CBorowski-dev/ShutterControlESP8266/electronics/ESP-12F SMD Board/ESP-12F Board.ods

Reference | Value | Footprint | Pollin | Reichelt | Preis | Stück
C1 | 22µF Tantal | Capacitor_Tantalum_SMD:CP_EIA-3528-21_Kemet-B_Pad1.50x2.35mm_HandSolder |  | https://www.reichelt.de/smd-tantal-22-f-16v-125-c-t491b-22u-16-p206454.html?&trstct=pos_6&nbc=1 | 0,23 | 10 | 2,3
C2 | 22µF Tantal | Capacitor_Tantalum_SMD:CP_EIA-3528-21_Kemet-B_Pad1.50x2.35mm_HandSolder |  | siehe C1 |  |  | 0
C3 | 100nF Kerko | Capacitor_SMD:C_1206_3216Metric_Pad1.42x1.75mm_HandSolder |  | https://www.reichelt.de/vielschicht-kerko-100nf-50v-125-c-kem-x7r1206b100n-p207152.html?trstct=pos_4&nbc=1 | 0,04 | 25 | 1
C4 | 100nF Kerko | Capacitor_SMD:C_1206_3216Metric_Pad1.42x1.75mm_HandSolder |  | siehe C3 |  |  | 0
C5 | 100µF Tantal | Capacitor_Tantalum_SMD:CP_EIA-3528-21_Kemet-B_Pad1.50x2.35mm_HandSolder |  | https://www.reichelt.de/smd-tantal-100-f-6v-125-c-t491b-100u-6-p206458.html?&trstct=pos_6&nbc=1 | 0,22 | 5 | 1,1
R1 | 10k | Resistor_SMD:R_1206_3216Metric_Pad1.42x1.75mm_HandSolder |  | https://www.reichelt.de/smd-widerstand-1206-10-kohm-250-mw-1-rnd-1206-1-10k-p183394.html?trstct=pos_3&nbc=1 | 0,02 | 50 | 1
R2 | 10k | Resistor_SMD:R_1206_3216Metric_Pad1.42x1.75mm_HandSolder |  | siehe R1 |  |  | 0
R3 | 10k | Resistor_SMD:R_1206_3216Metric_Pad1.42x1.75mm_HandSolder |  | siehe R1 |  |  | 0
R4 | 10k | Resistor_SMD:R_1206_3216Metric_Pad1.42x1.75mm_HandSolder |  | siehe R1 |  |  | 0
U2 | AMS1117-3.3 | Package_TO_SOT_SMD:SOT-223 |  |  |  |  | 0
 |  |  |  |  |  |  | 0
J3 | Conn_01x10_Male | Connector_PinHeader_2.54mm:PinHeader_1x10_P2.54mm_Vertical | https://www.pollin.de/p/stiftleiste-vergoldet-1x-20-polig-10-stueck-451550 |  | 2,75 | 1 | 2,75
 |  |  |  | https://www.reichelt.de/stiftleiste-20-polig-raster-2-54mm-bkl-10120204-p235649.html?trstct=pol_1&nbc=1 | 0,33 | 6 | 1,98
J4 | Conn_01x08_Male | Connector_PinHeader_2.54mm:PinHeader_1x08_P2.54mm_Vertical | siehe J3 |  |  |  | 0
J1 | Conn_01x04_Male | Connector_PinHeader_2.54mm:PinHeader_1x04_P2.54mm_Vertical | siehe J3 |  |  |  | 0
SW1 | SW_Reset | Button_Switch_THT:SW_PUSH_6mm | https://www.pollin.de/p/printtaster-mikro-eingabetaster-420035 |  | 0,14 | 15 | 2,1
 |  |  |  | https://www.reichelt.de/printtaster-tht-2-45-n-6-x-6-x-5-mm-rnd-210-00193-p226414.html?trstct=pos_6&nbc=1 | 0,15 | 15 | 2,25
SW2 | SW_Flash | Button_Switch_THT:SW_PUSH_6mm | siehe SW1 |  |  |  | 0
 |  |  |  |  |  |  | 0
 |  |  |  |  |  |  | 0
 |  |  |  |  |  |  | 0
 |  |  |  |  |  |  | 0
 |  | Wippschalter | https://www.pollin.de/p/wippenschalter-mrs-101-420241 |  | 0,35 | 2 | 0,7
 |  |  |  | https://www.reichelt.de/miniatur-wippschalter-ein-aus-mit-aufdruck-schwarz-rnd-210-00545-p253075.html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 | 0,9 | 2 | 1,8
 |  | Taster | https://www.pollin.de/p/eingabetaster-d6r-schwarz-420774 |  | 0,15 | 18 | 2,7
 |  |  |  | https://www.reichelt.de/eingabetaster-schaltspannung-100v-rund-ws-dt-6-ws-p7242.html?trstct=pol_1&nbc=1 | 0,66 | 18 | 11,88
 |  | Steckdosenleiste | https://www.pollin.de/p/steckdosenleiste-rev-smart-3-fach-mit-flachstecker-2-m-weiss-552991 |  | 7,95 | 1 | 7,95
 |  | USB-Kabel C auf A | https://www.pollin.de/p/usb2-0-kabel-hama-a-auf-c-1-m-schwarz-713406 |  | 1,95 | 1 | 1,95
 |  | Reichelt Versand |  |  | 5,95
 |  | Pollin Versand |  |  | 5,95
