CBorowski-dev/ShutterControlESP8266/case/ShutterControl V1 Bottom.stl

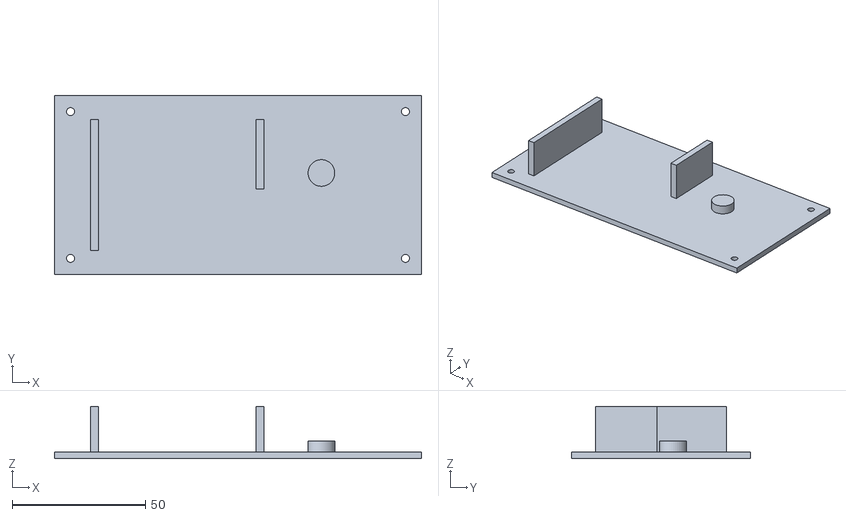
[picture p1: CAD file, 2025-10-25]
case/ShutterControl V1 Bottom.stl
137.5 x 67.0 x 19.5
