CBorowski-dev/ShutterControlESP8266/case/ShutterControl V1 Inlay.stl

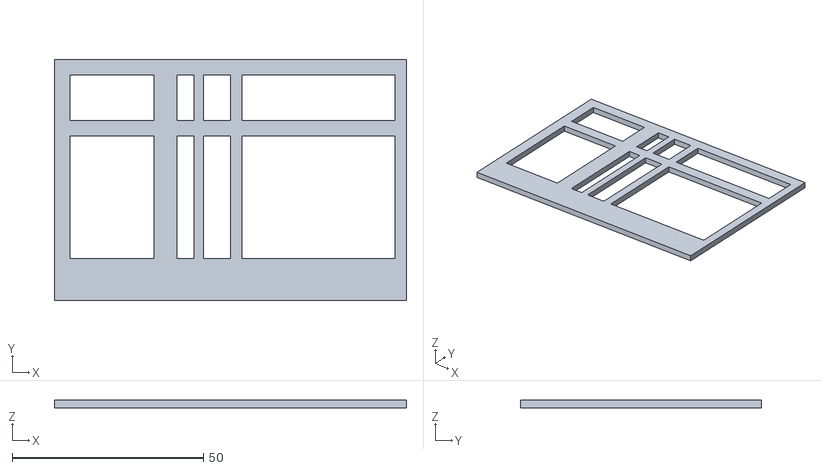
[picture p2: CAD file, 2020-05-11]
case/ShutterControl V1 Inlay.stl
92.0 x 63.0 x 2.00
