CBorowski-dev/ShutterControlESP8266/case/ShutterControl V1 Top.stl

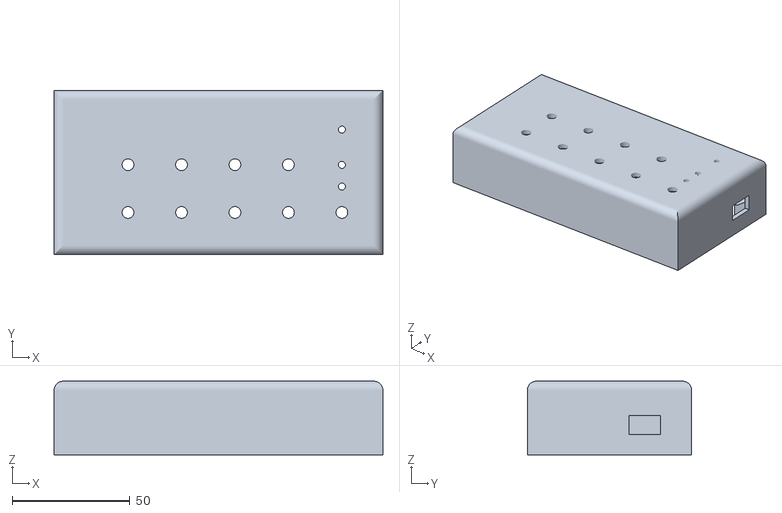
[picture p3: CAD file, 2020-05-11]
case/ShutterControl V1 Top.stl
140.0 x 70.0 x 31.4
