CBorowski-dev/ShutterControlESP8266/electronics/ShutterControl/ShutterControl.pdf

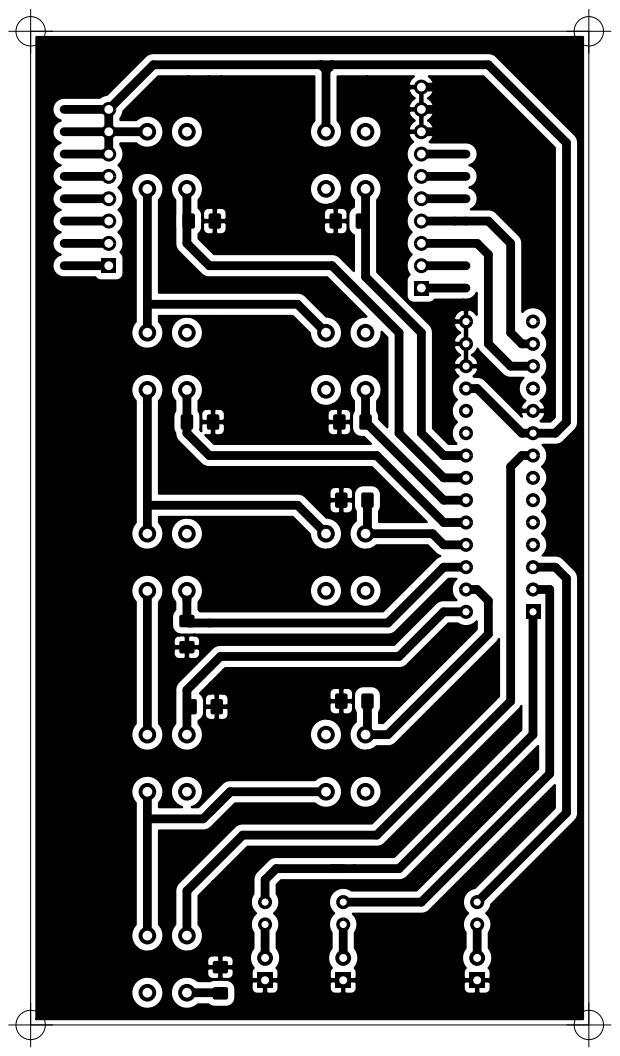
[picture p4: page 1]
