CBorowski-dev/ShutterControlESP8266/electronics/ShutterControl/ShutterControl.kicad_pcb

## KiCad design electronics/ShutterControl/ShutterControl.kicad_pcb (2020-05-11)

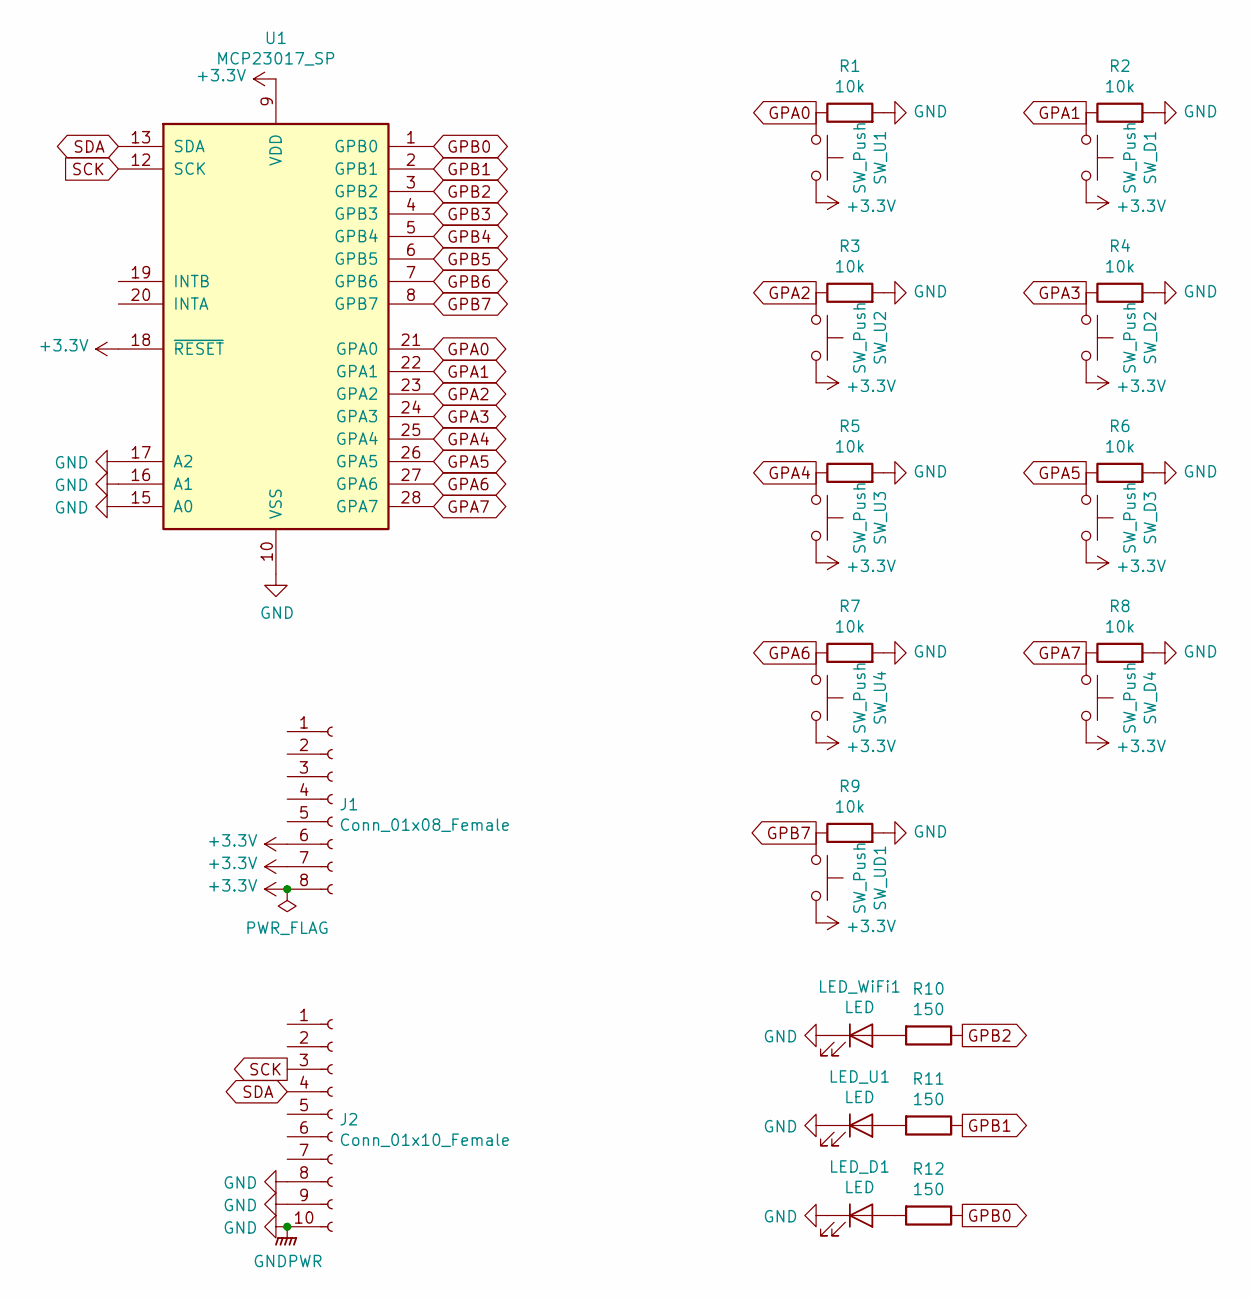
[picture p5: schematic ShutterControl.sch]

Parts:
J1: Conn_01x08_Female; PinHeader_1x08_P2.54mm_Vertical
J2: Conn_01x10_Female; PinHeader_1x10_P2.54mm_Vertical
LED_D1: LED; LED_D3.0mm_Clear
LED_U1: LED; LED_D3.0mm_Clear
LED_WiFi1: LED; LED_D3.0mm_Clear
R1, R2, R3, R4, R5, R6, R7, R8, R9: 10k; R_1206_3216Metric_Pad1.42x1.75mm_HandSolder
R10, R11, R12: 150; R_Axial_DIN0207_L6.3mm_D2.5mm_P2.54mm_Vertical
SW_D1, SW_D2, SW_D3, SW_D4: SW_Push; SW_PUSH_6mm_H7.3mm
SW_U1, SW_U2, SW_U3, SW_U4: SW_Push; SW_PUSH_6mm_H7.3mm
SW_UD1: SW_Push; SW_PUSH_6mm_H7.3mm
U1: MCP23017_SP; DIP-28_W7.62mm

Connections:
+3V3: J1.6, J1.7, J1.8, SW_D1.2, SW_D2.2, SW_D3.2, SW_D4.2, SW_U1.2, SW_U2.2, SW_U3.2, SW_U4.2, SW_UD1.2, U1.9 (VDD), U1.18 (~RESET~)
GND: J2.8, J2.9, J2.10, LED_D1.1 (K), LED_U1.1 (K), LED_WiFi1.1 (K), R1.2, R2.2, R3.2, R4.2, R5.2, R6.2, R7.2, R8.2, R9.2, U1.10 (VSS), U1.15 (A0), U1.16 (A1), U1.17 (A2)
GPA0: R1.1, SW_U1.1, U1.21 (GPA0)
GPA1: R2.1, SW_D1.1, U1.22 (GPA1)
GPA2: R3.1, SW_U2.1, U1.23 (GPA2)
GPA3: R4.1, SW_D2.1, U1.24 (GPA3)
GPA4: R5.1, SW_U3.1, U1.25 (GPA4)
GPA5: R6.1, SW_D3.1, U1.26 (GPA5)
GPA6: R7.1, SW_U4.1, U1.27 (GPA6)
GPA7: R8.1, SW_D4.1, U1.28 (GPA7)
GPB0: R12.1, U1.1 (GPB0)
GPB1: R11.1, U1.2 (GPB1)
GPB2: R10.1, U1.3 (GPB2)
GPB3: U1.4 (GPB3)
GPB4: U1.5 (GPB4)
GPB5: U1.6 (GPB5)
GPB6: U1.7 (GPB6)
GPB7: R9.1, SW_UD1.1, U1.8 (GPB7)
unnamed: LED_D1.2 (A), R12.2
unnamed: LED_U1.2 (A), R11.2
unnamed: LED_WiFi1.2 (A), R10.2
SCK: J2.3, U1.12 (SCK)
SDA: J2.4, U1.13 (SDA)

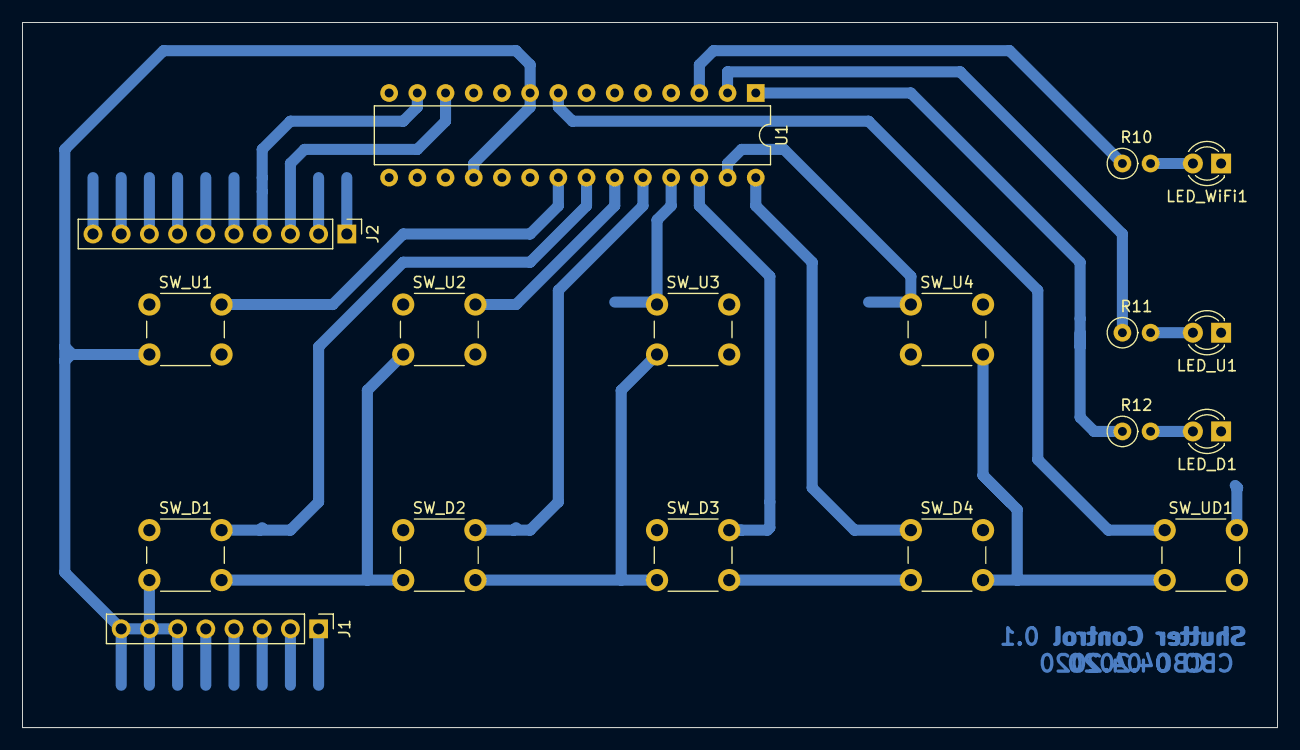
[picture p6: board ShutterControl.kicad_pcb from above]

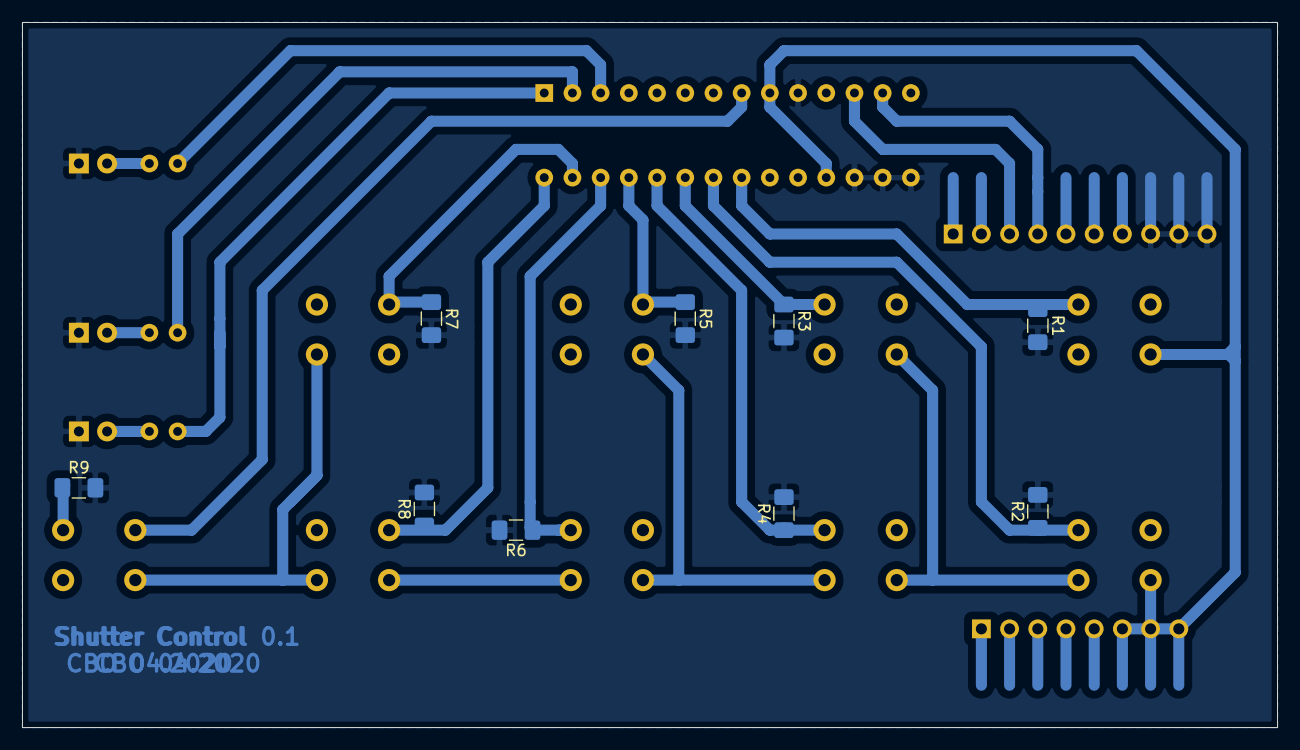
[picture p7: board ShutterControl.kicad_pcb from below]

Board: 2 copper layers, 113.0 x 63.5 mm, 27 parts (9 on the bottom side), 19 nets.
