CBorowski-dev/ShutterControlESP8266/electronics/ESP-12F SMD Board/ESP-12F Board.kicad_pcb

## KiCad design electronics/ESP-12F SMD Board/ESP-12F Board.kicad_pcb (2020-05-11)

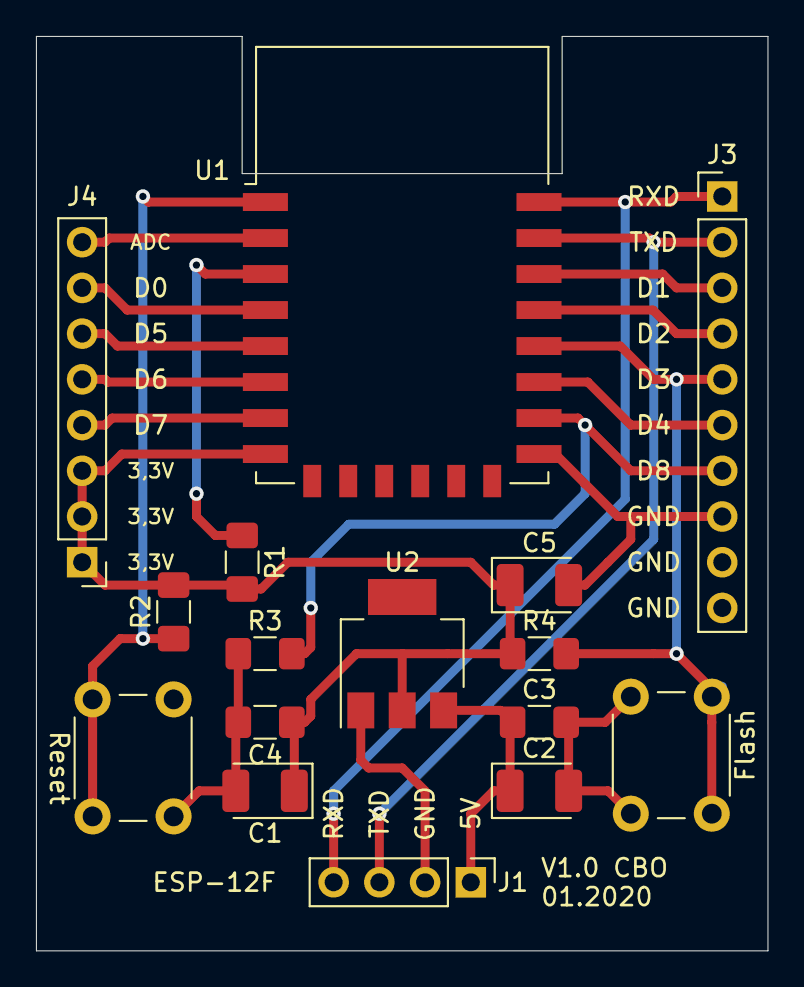
[picture p8: board ESP-12F Board.kicad_pcb from above]

Board: 2 copper layers, 40.6 x 50.8 mm, 16 parts (0 on the bottom side), 17 nets.

Parts:
C1, C2: 22µF Tantal; CP_EIA-3528-21_Kemet-B_Pad1.50x2.35mm_HandSolder
C3, C4: 100nF Kerko; C_1206_3216Metric_Pad1.42x1.75mm_HandSolder
C5: 100µF Tantal; CP_EIA-3528-21_Kemet-B_Pad1.50x2.35mm_HandSolder
Flash: SW_Flash; SW_PUSH_6mm
J1: Conn_01x04_Male; PinHeader_1x04_P2.54mm_Vertical
J3: Conn_01x10_Male; PinHeader_1x10_P2.54mm_Vertical
J4: Conn_01x08_Male; PinHeader_1x08_P2.54mm_Vertical
R1, R2, R3, R4: 10k; R_1206_3216Metric_Pad1.42x1.75mm_HandSolder
Reset: SW_Reset; SW_PUSH_6mm
U1: ESP-12F; ESP-12E
U2: AMS1117-3.3; SOT-223

Connections:
+5V: C2.1, C3.1, J1.1, U2.3
/ADC: J4.8, U1.2
/GPIO0: Flash.2, J3.5, R4.2, U1.18
/GPIO2: J3.6, U1.17
/GPIO4: J3.4, U1.19
/GPIO5: J3.3, U1.20
/GPIO12: J4.5, U1.6
/GPIO13: J4.4, U1.7
/GPIO14: J4.6, U1.5
/GPIO15: J3.7, R3.2, U1.16
/GPIO16: J4.7, U1.4
/RXD: J1.4, J3.1, U1.22
/TXD: J1.3, J3.2, U1.21
/VCC: C1.1, C4.1, C5.1, J4.1, J4.2, J4.3, R1.2, R2.2, R4.1, U1.8, U2.2
GND: C1.2, C2.2, C3.2, C4.2, C5.2, Flash.1, J1.2, J3.8, J3.9, J3.10, R3.1, Reset.1, U1.15, U2.1
unnamed: R1.1, U1.3
unnamed: R2.1, Reset.2, U1.1
