CBorowski-dev/ShutterControlESP8266/(commit log)

2020-05-11 Initial version
    [ESP-12F Board-B_Cu.gbr, ESP-12F Board-B_Mask.gbr, ESP-12F Board-B_SilkS.gbr, ESP-12F Board-Edge_Cuts.gbr, ESP-12F Board-F_Cu.gbr, ESP-12F Board-F_Mask.gbr, ESP-12F Board-F_SilkS.gbr, ESP-12F Board-NPTH.drl]
2020-10-04 Changes due to add hardware buttons
2025-10-25 Added additional lights
    [ShutterControl V1 Bottom.scad, ShutterControl V1 Bottom.stl]
